jpaustin/fairyhouse/FairyControler.pdf

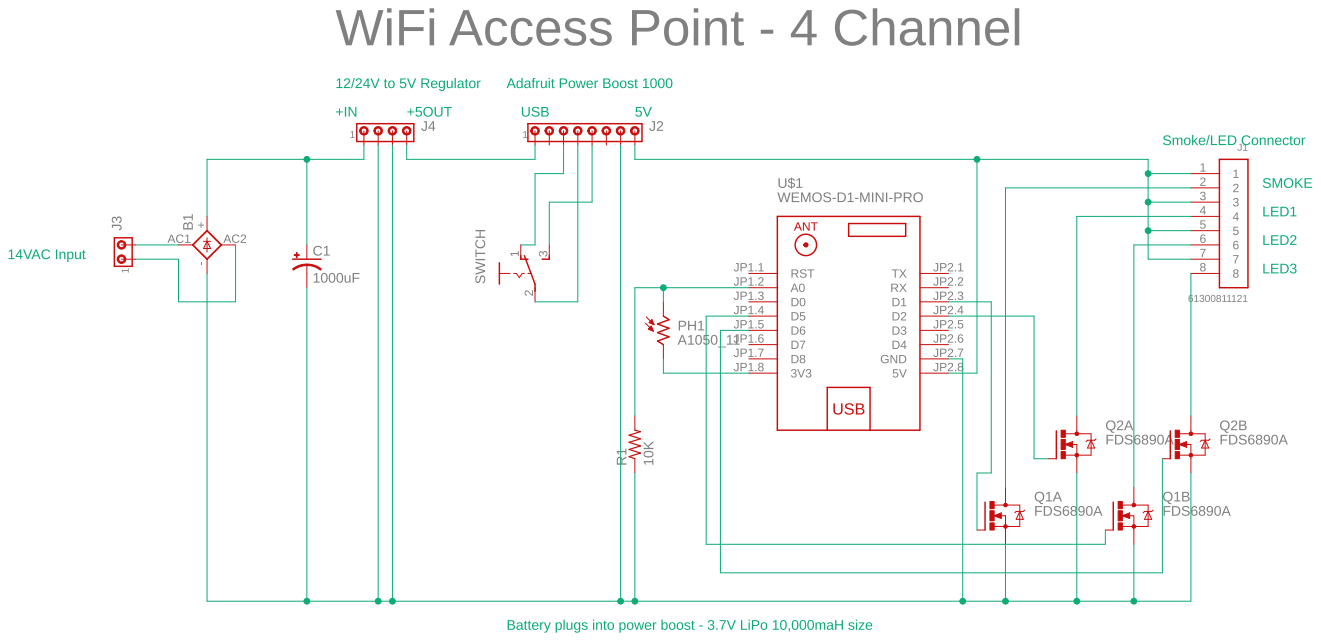
[picture p1: page 1]
