jpaustin/fairyhouse/FairyControler.sch

## EAGLE design FairyControler.sch (2019-12-20)

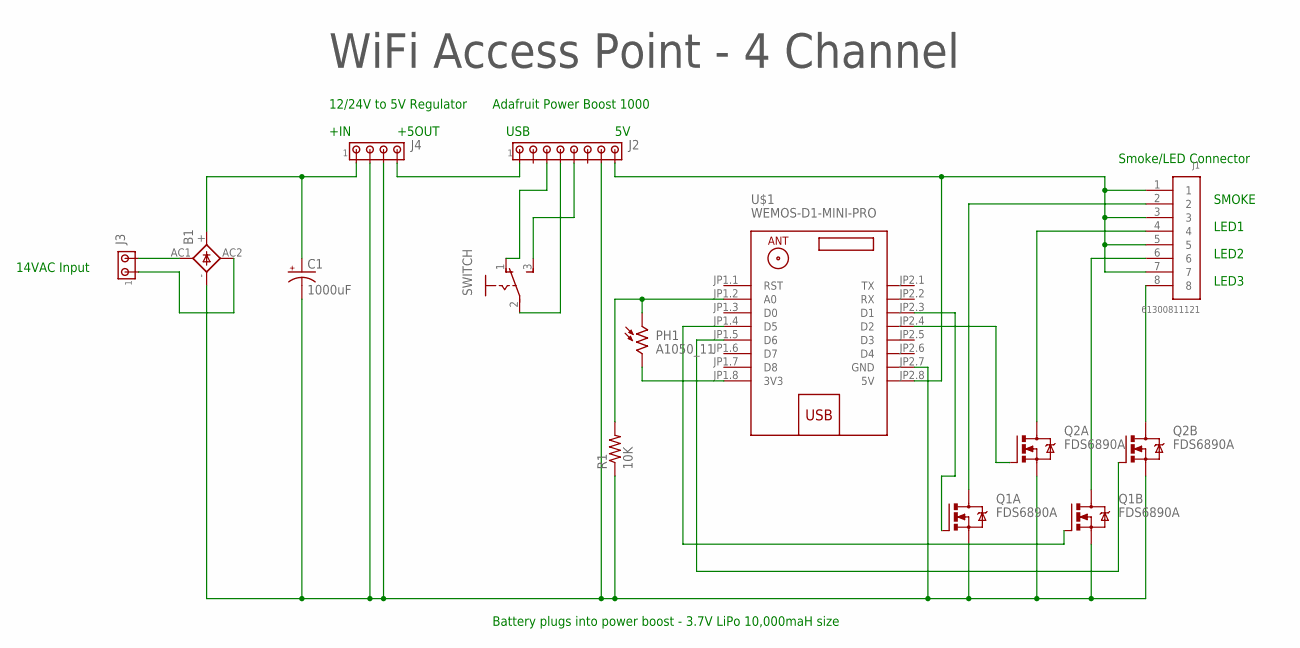
[picture p2: schematic FairyControler.sch]

Parts:
B1: 2KBP
C1: 1000uF; E3,5-10
J1: 61300811121
J2: MTA08-100; 10X08MTA
J3: MTA02-100; 10X02MTA
J4: MTA04-100; 10X04MTA
PH1: A1050_11; T0-46-A10XX
Q1, Q2: FDS6890A; M08A
R1: 10K; 0204/7
SWITCH: 255SB
U$1: WEMOS-D1-MINI-PRO

Connections:
unnamed: B1.AC1, J3.2
unnamed: B1.AC2, J3.1
unnamed: B1.+, C1.+, J4.1
unnamed: B1.-, C1.-, J2.7, J4.2, J4.3, Q1.1 (S), Q1.3 (S), Q2.1 (S), Q2.3 (S), R1.1, U$1.JP2.7 (GND)
unnamed: J2.1, J4.4
unnamed: J2.4, SWITCH.2
unnamed: J2.5, SWITCH.3 (S)
unnamed: J2.3, SWITCH.1 (O)
unnamed: J1.1, J1.3, J1.5, J1.7, J2.8, U$1.JP2.8 (5V)
unnamed: PH1.1, R1.2, U$1.JP1.2 (A0)
unnamed: J1.2, Q1.7 (D)
unnamed: J1.4, Q2.7 (D)
unnamed: J1.6, Q1.5 (D)
unnamed: J1.8, Q2.5 (D)
unnamed: Q1.2 (G), U$1.JP2.3 (D1)
unnamed: Q2.2 (G), U$1.JP2.4 (D2)
unnamed: Q1.4 (G), U$1.JP1.4 (D5)
unnamed: Q2.4 (G), U$1.JP1.5 (D6)
unnamed: PH1.2, U$1.JP1.8 (3V3)

Notes on the sheet:
Adafruit Power Boost 1000
14VAC Input
12/24V to 5V Regulator
+IN
+5OUT
USB
SMOKE
LED1
LED2
LED3
Smoke/LED Connector
WiFi Access Point - 4 Channel
Battery plugs into power boost - 3.7V LiPo 10,000maH size
